Axileftx/Turtle-like-amphibious-robot/image2.png

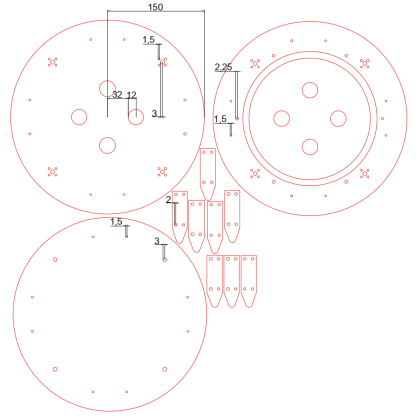
image2.png
