Axileftx/Turtle-like-amphibious-robot/image3.png

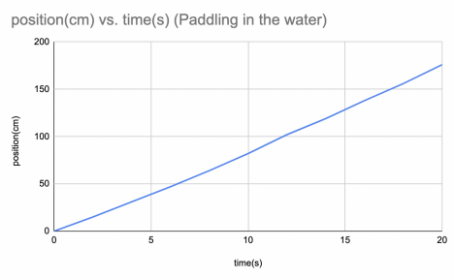
image3.png
