Axileftx/Turtle-like-amphibious-robot/image4.png

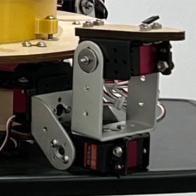
image4.png
