Axileftx/Turtle-like-amphibious-robot/image5.png

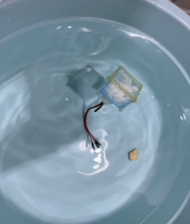
image5.png
