Axileftx/Turtle-like-amphibious-robot/image6.png

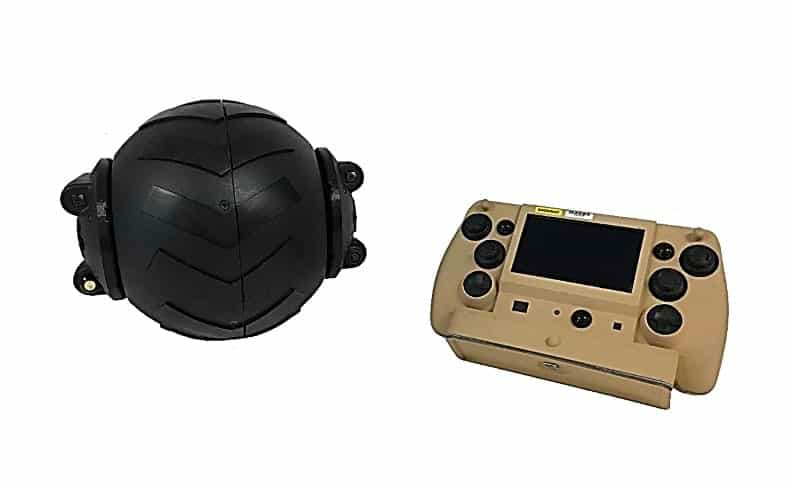
image6.png
