Axileftx/Turtle-like-amphibious-robot/image7.png

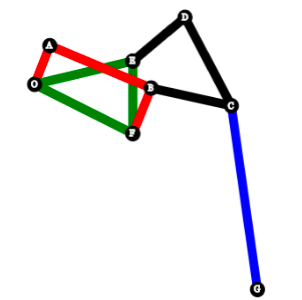
image7.png
