Axileftx/Turtle-like-amphibious-robot/image9.png

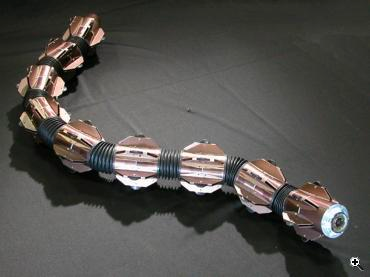
image9.png
