Axileftx/Turtle-like-amphibious-robot/image10.png

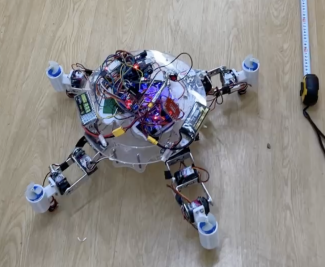
image10.png
