Axileftx/Turtle-like-amphibious-robot/image11.png

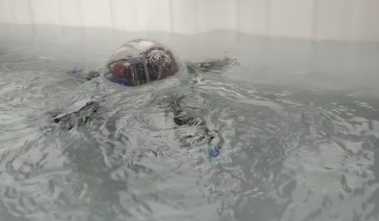
image11.png
