Axileftx/Turtle-like-amphibious-robot/image12.png

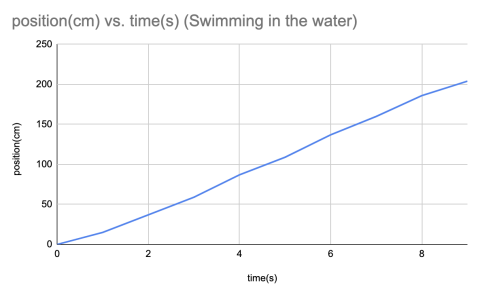
image12.png
