Axileftx/Turtle-like-amphibious-robot/image13.jpg

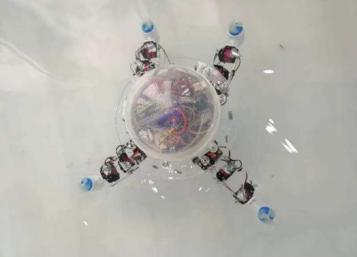
image13.jpg
