Axileftx/Turtle-like-amphibious-robot/image18.png

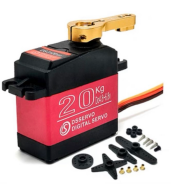
image18.png
