Axileftx/Turtle-like-amphibious-robot/image19.png

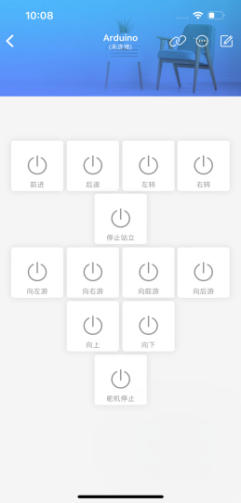
image19.png
