Axileftx/Turtle-like-amphibious-robot/image30.png

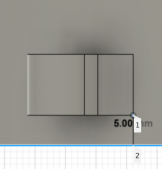
image30.png
