Axileftx/Turtle-like-amphibious-robot/image32.png

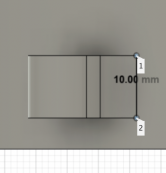
image32.png
