Axileftx/Turtle-like-amphibious-robot/image35.png

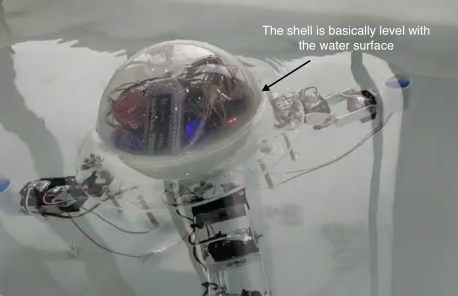
image35.png
