Axileftx/Turtle-like-amphibious-robot/image36.png

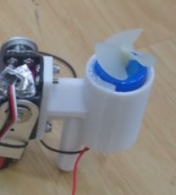
image36.png
