Axileftx/Turtle-like-amphibious-robot/image37.png

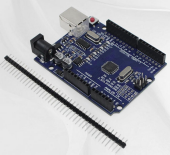
image37.png
