Axileftx/Turtle-like-amphibious-robot/image40.png

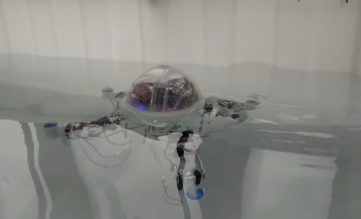
image40.png
