Axileftx/Turtle-like-amphibious-robot/image41.png

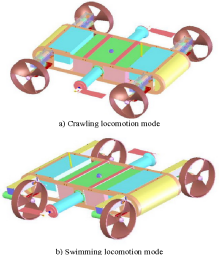
image41.png
