Axileftx/Turtle-like-amphibious-robot/image47.png

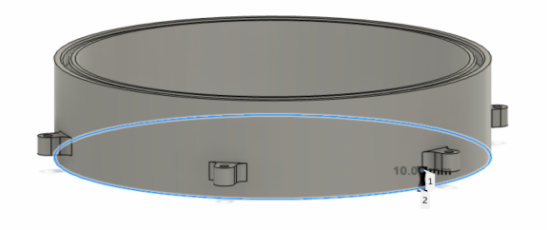
image47.png
