Axileftx/Turtle-like-amphibious-robot/image54.png

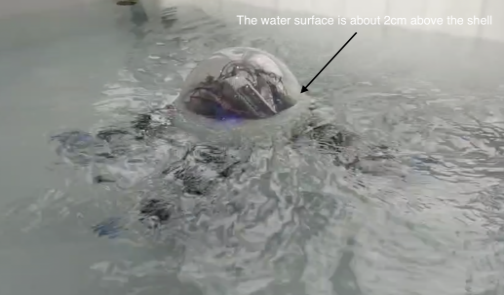
image54.png
