Axileftx/Turtle-like-amphibious-robot/image60.png

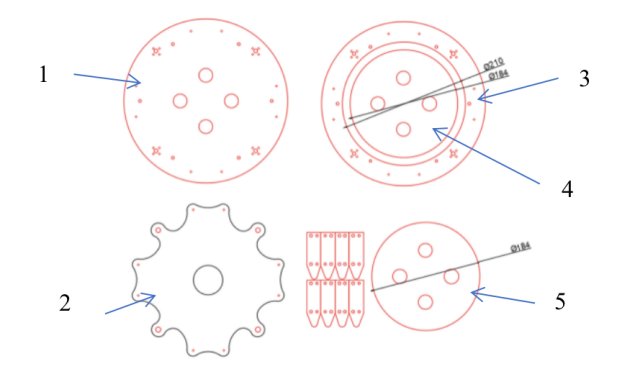
image60.png
