Axileftx/Turtle-like-amphibious-robot/image61.png

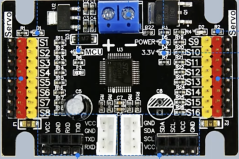
image61.png
