Axileftx/Turtle-like-amphibious-robot/image62.png

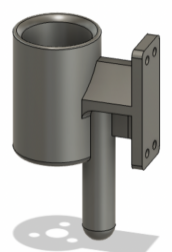
image62.png
