Axileftx/Turtle-like-amphibious-robot/image63.png

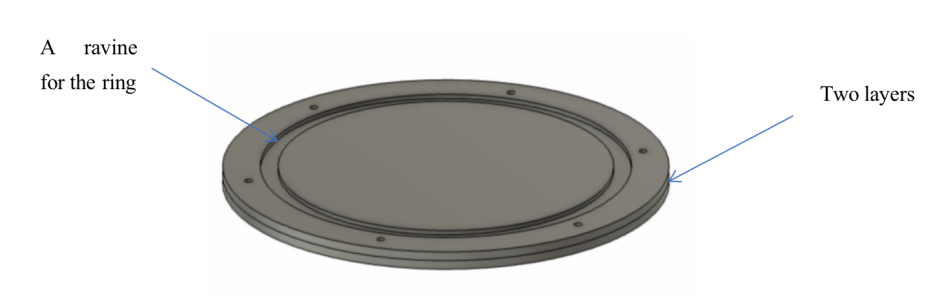
image63.png
