Axileftx/Turtle-like-amphibious-robot/image64.png

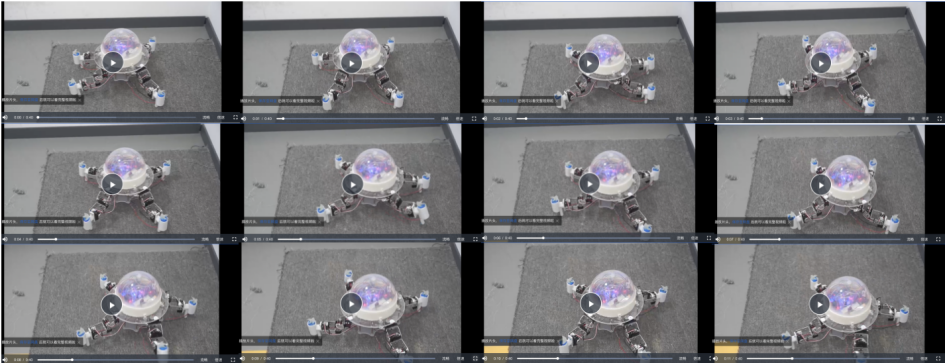
image64.png
