Axileftx/Turtle-like-amphibious-robot/image65.png

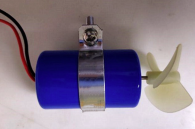
image65.png
