Axileftx/Turtle-like-amphibious-robot/image66.png

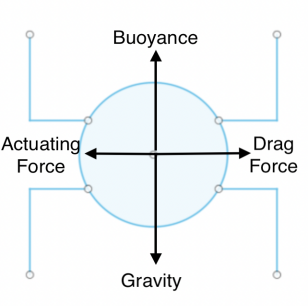
image66.png
