Axileftx/Turtle-like-amphibious-robot/image67.png

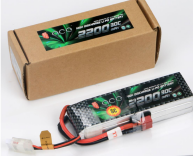
image67.png
