Axileftx/Turtle-like-amphibious-robot/image68.png

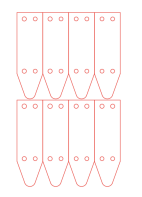
image68.png
