Axileftx/Turtle-like-amphibious-robot/image69.png

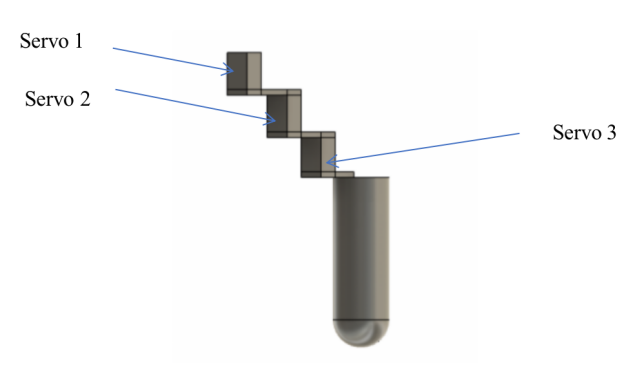
image69.png
