Axileftx/Turtle-like-amphibious-robot/image70.png

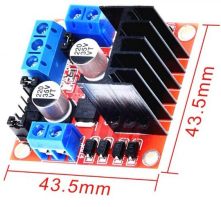
image70.png
