Axileftx/Turtle-like-amphibious-robot/image71.png

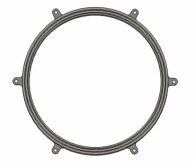
image71.png
