Axileftx/Turtle-like-amphibious-robot/image72.png

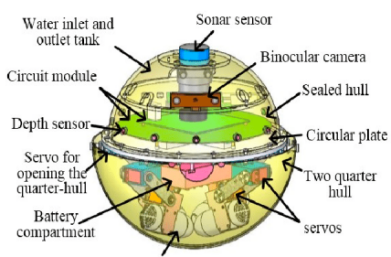
image72.png
