Axileftx/Turtle-like-amphibious-robot/image81.png

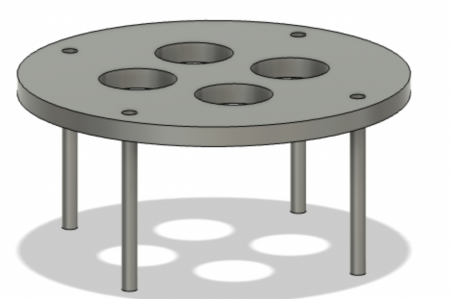
image81.png
