Axileftx/Turtle-like-amphibious-robot/image96.png

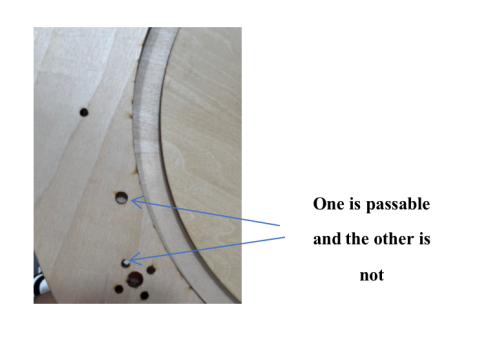
image96.png
