Axileftx/Turtle-like-amphibious-robot/image97.png

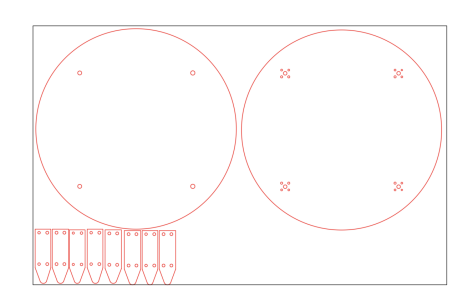
image97.png
