Axileftx/Turtle-like-amphibious-robot/image101.png

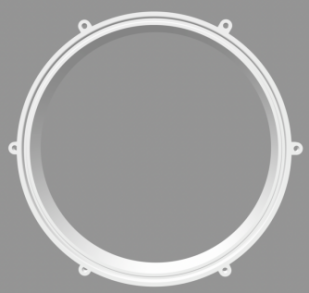
image101.png
