Axileftx/Turtle-like-amphibious-robot/image102.png

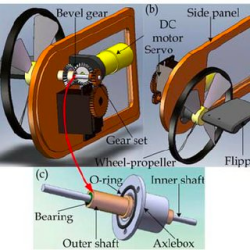
image102.png
