Axileftx/Turtle-like-amphibious-robot/image111.png

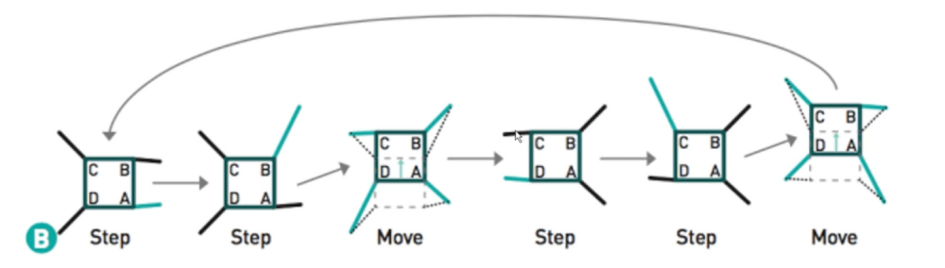
image111.png
