Axileftx/Turtle-like-amphibious-robot/image113.png

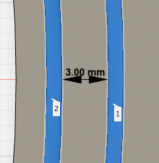
image113.png
