Axileftx/Turtle-like-amphibious-robot/image119.png

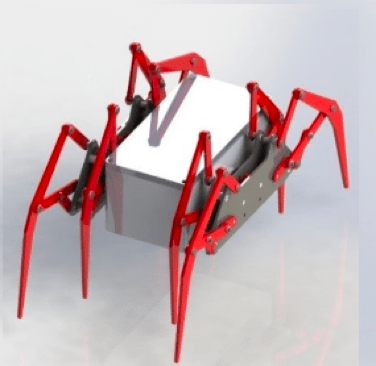
image119.png
