Axileftx/Turtle-like-amphibious-robot/image120.png

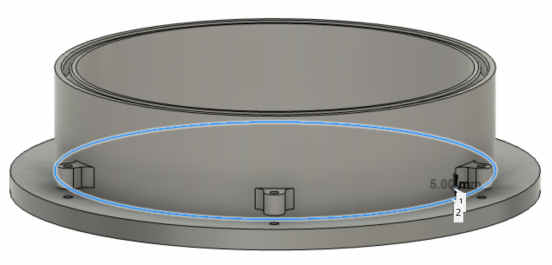
image120.png
