Axileftx/Turtle-like-amphibious-robot/image125.png

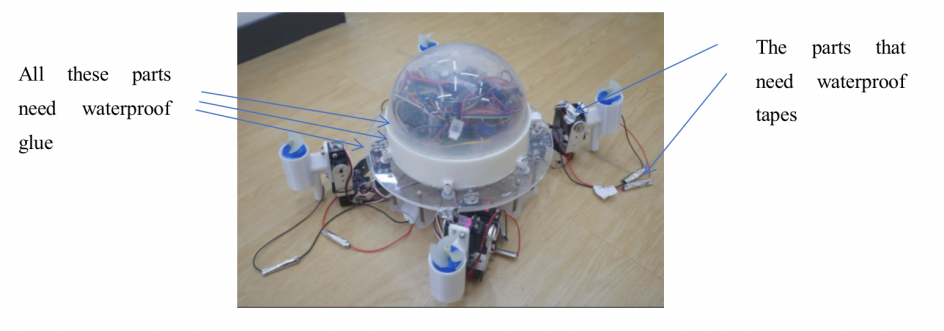
image125.png
