Axileftx/Turtle-like-amphibious-robot/image127.png

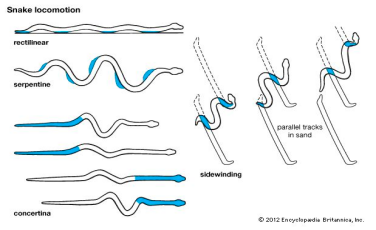
image127.png
