Axileftx/Turtle-like-amphibious-robot/image133.png

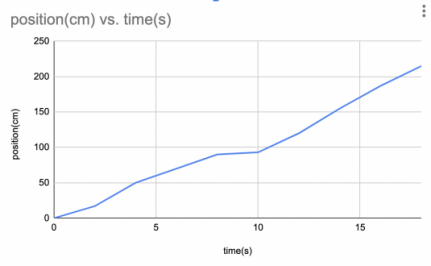
image133.png
