Axileftx/Turtle-like-amphibious-robot/image134.png

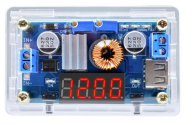
image134.png
