Axileftx/Turtle-like-amphibious-robot/image135.png

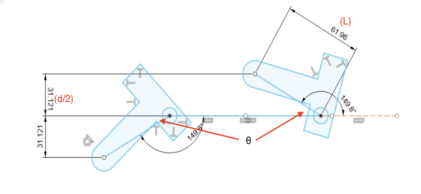
image135.png
