Axileftx/Turtle-like-amphibious-robot/image136.png

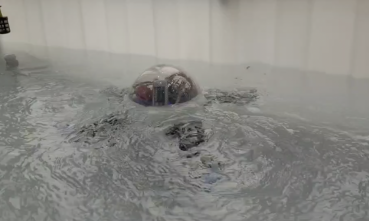
image136.png
