Axileftx/Turtle-like-amphibious-robot/image137.png

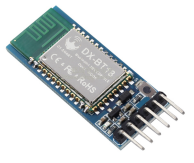
image137.png
