Axileftx/Turtle-like-amphibious-robot/image155.png

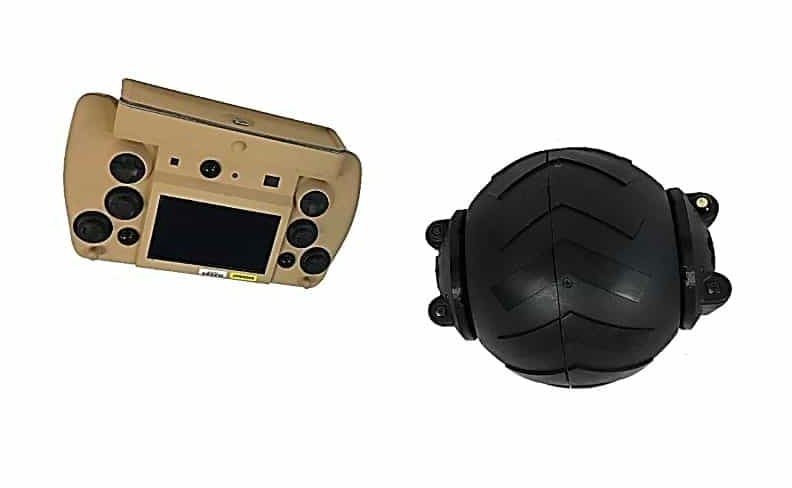
image155.png
